freedom413/miniroot/img/9.png

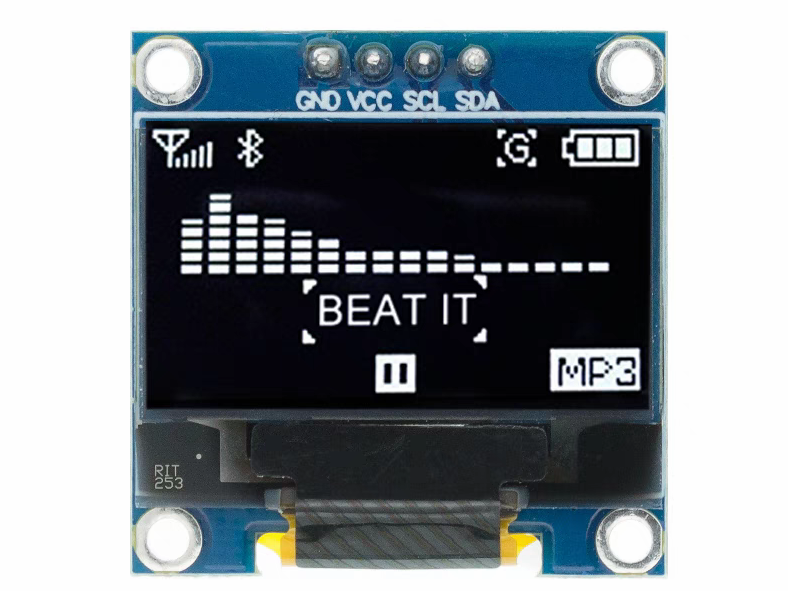
img/9.png
