freedom413/miniroot/img/正面.jpg

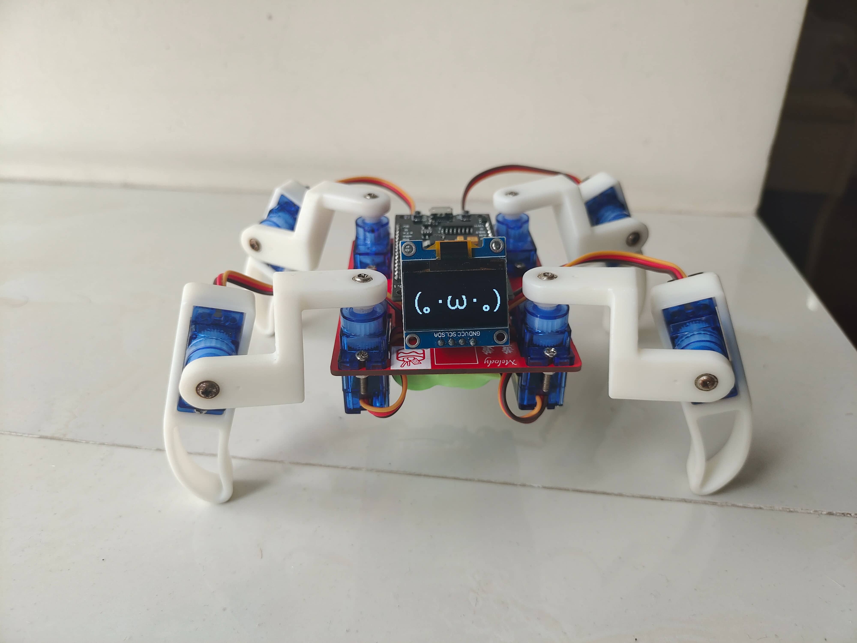
img/正面.jpg
