freedom413/miniroot/img/1.png

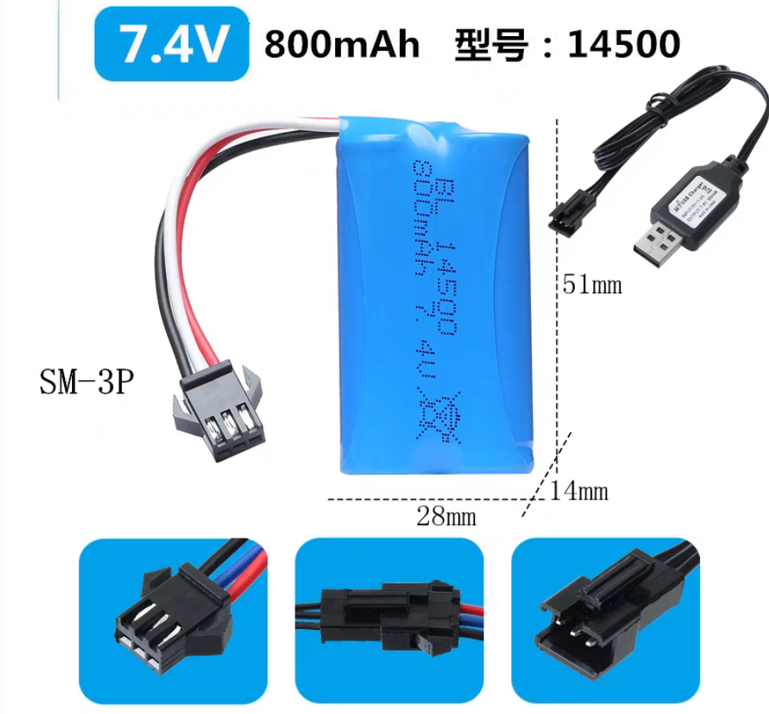
img/1.png
