freedom413/miniroot/img/2.png

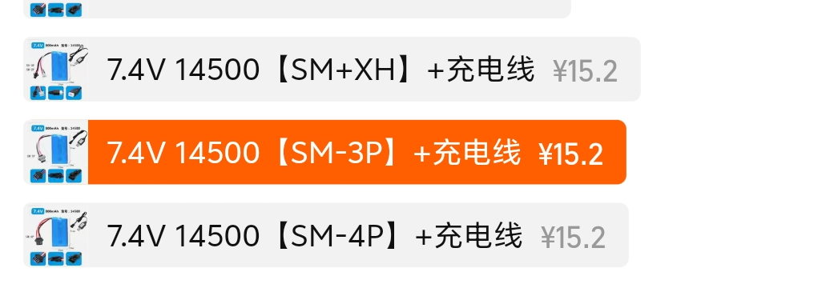
img/2.png
