freedom413/miniroot/img/3.png

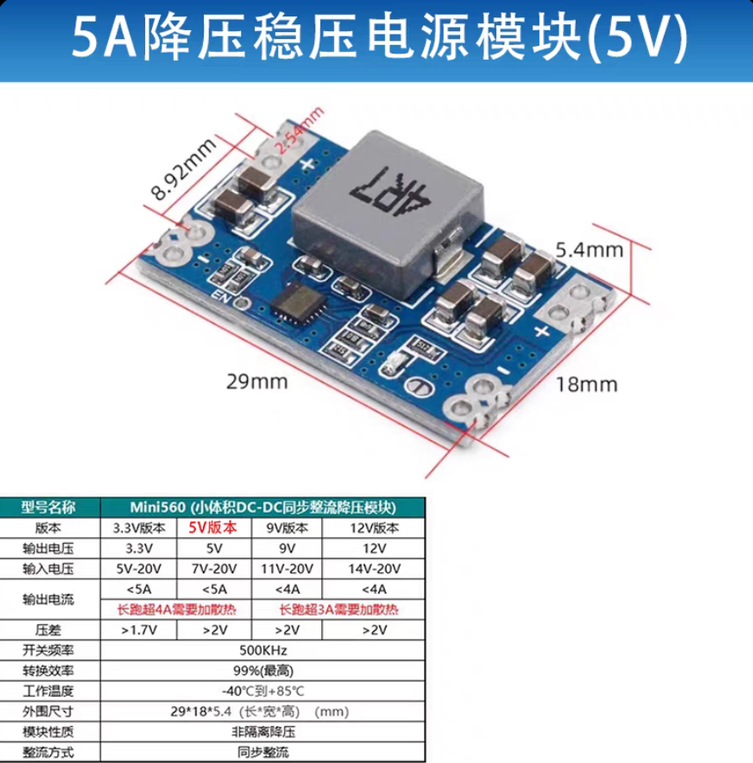
img/3.png
