freedom413/miniroot/img/4.png

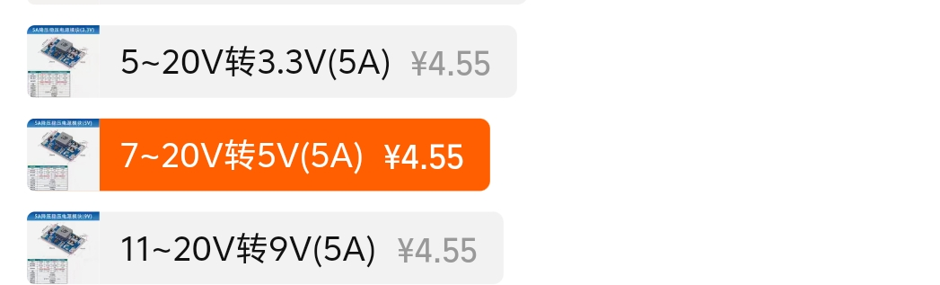
img/4.png
