freedom413/miniroot/img/5.png

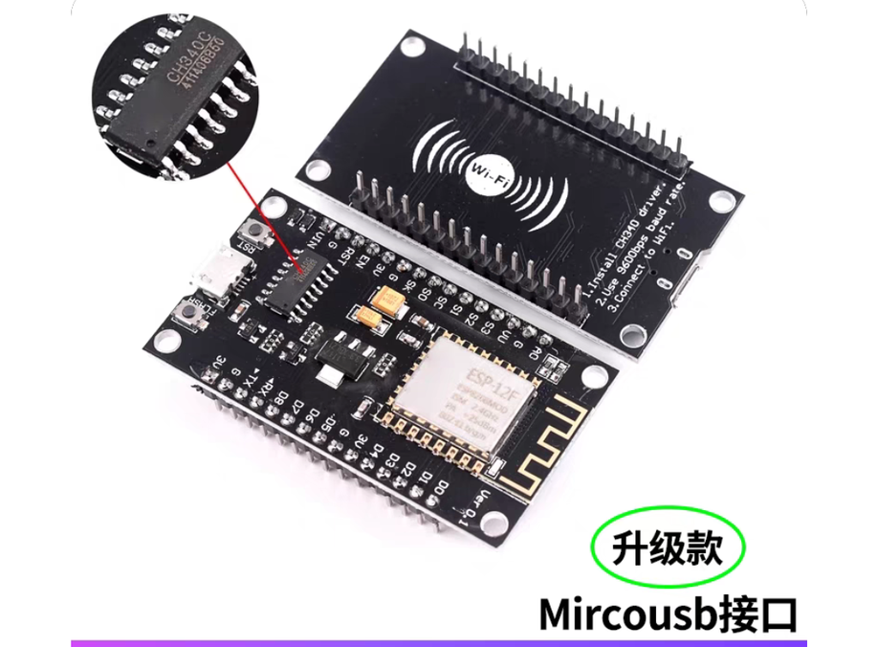
img/5.png
