freedom413/miniroot/img/6.png

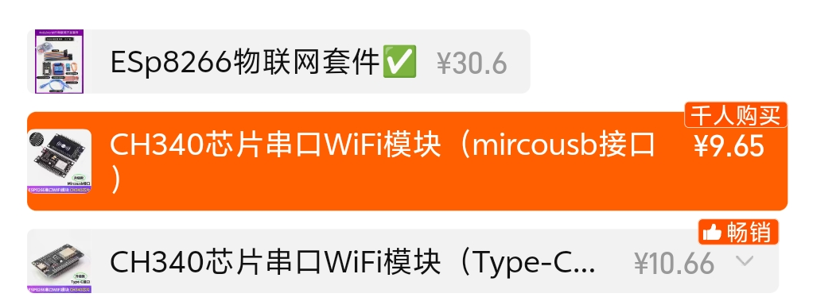
img/6.png
