freedom413/miniroot/img/7.png

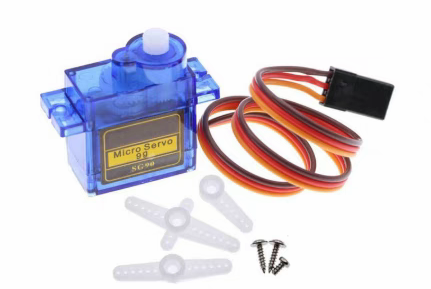
img/7.png
