freedom413/miniroot/img/8.png

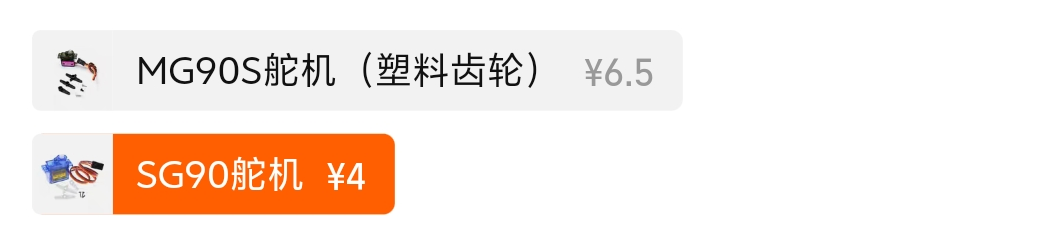
img/8.png
