freedom413/miniroot/img/10.png

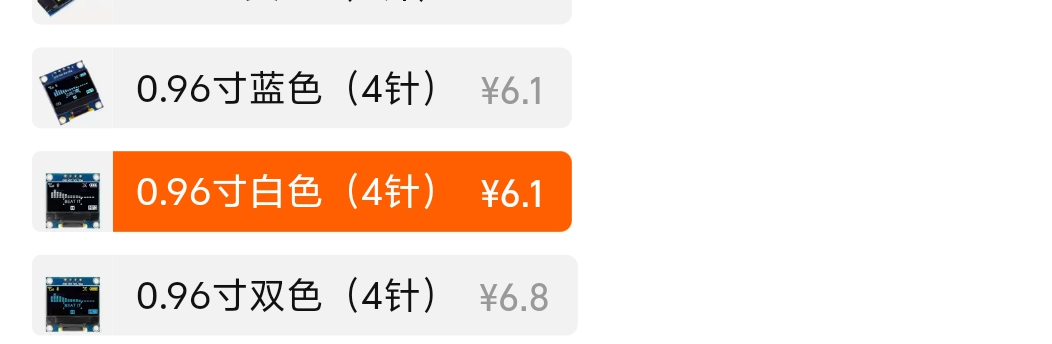
img/10.png
