freedom413/miniroot/img/11.png

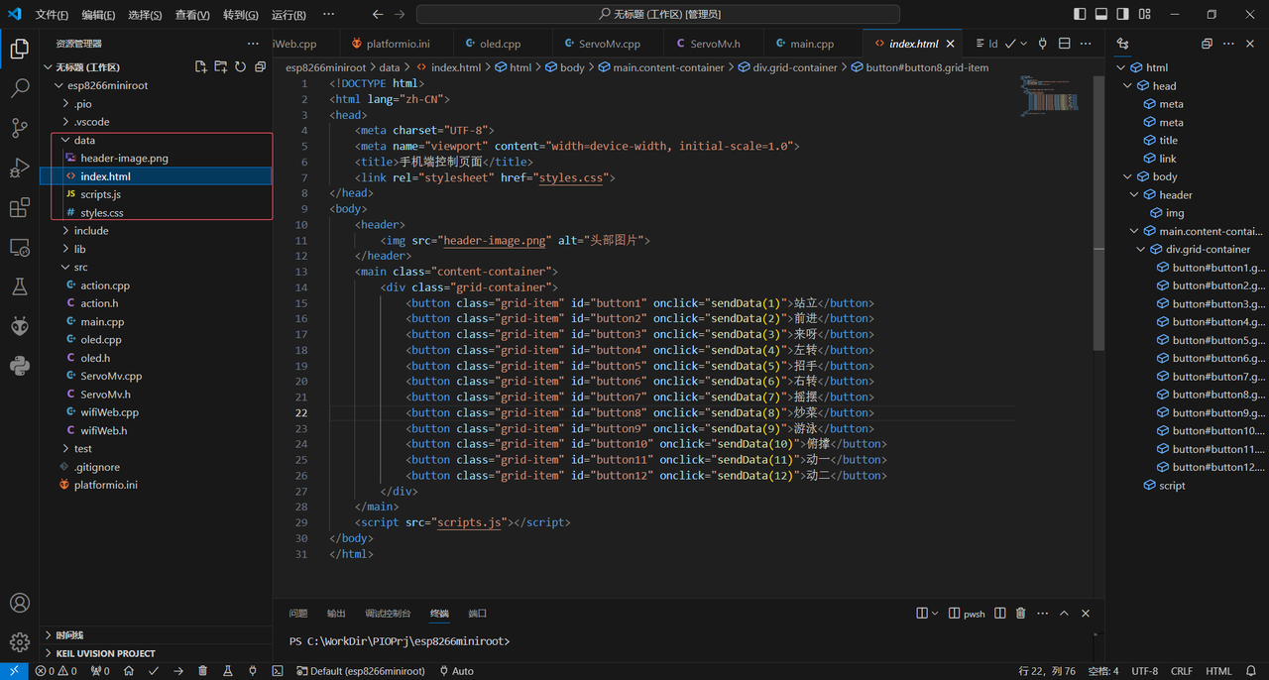
img/11.png
