freedom413/miniroot/img/12.png

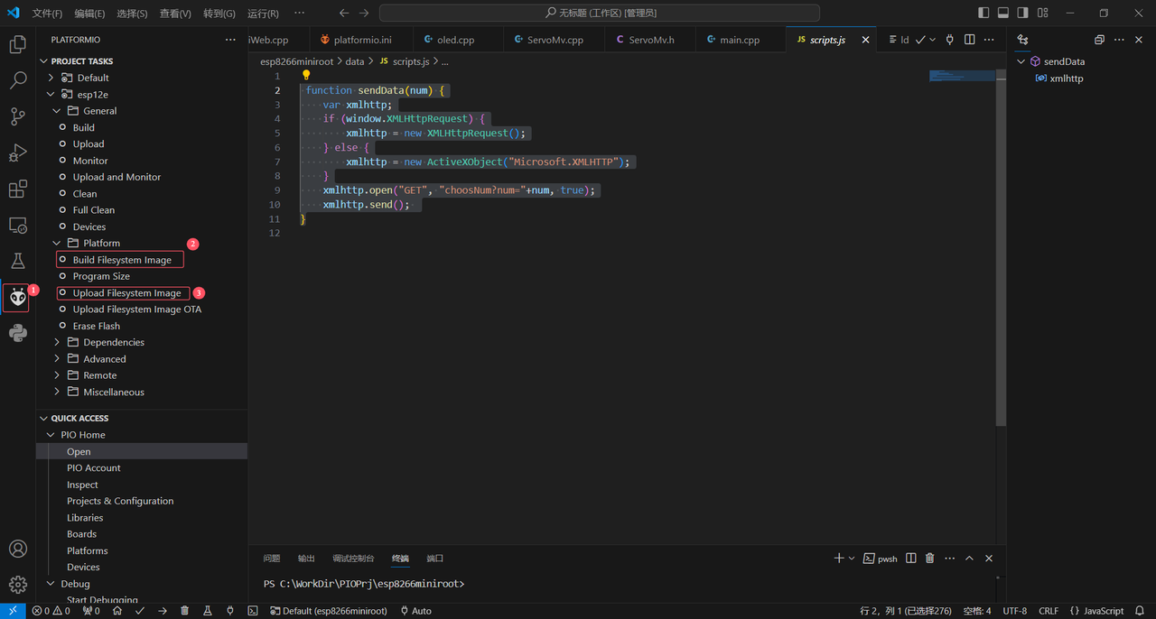
img/12.png
