freedom413/miniroot/img/model.png

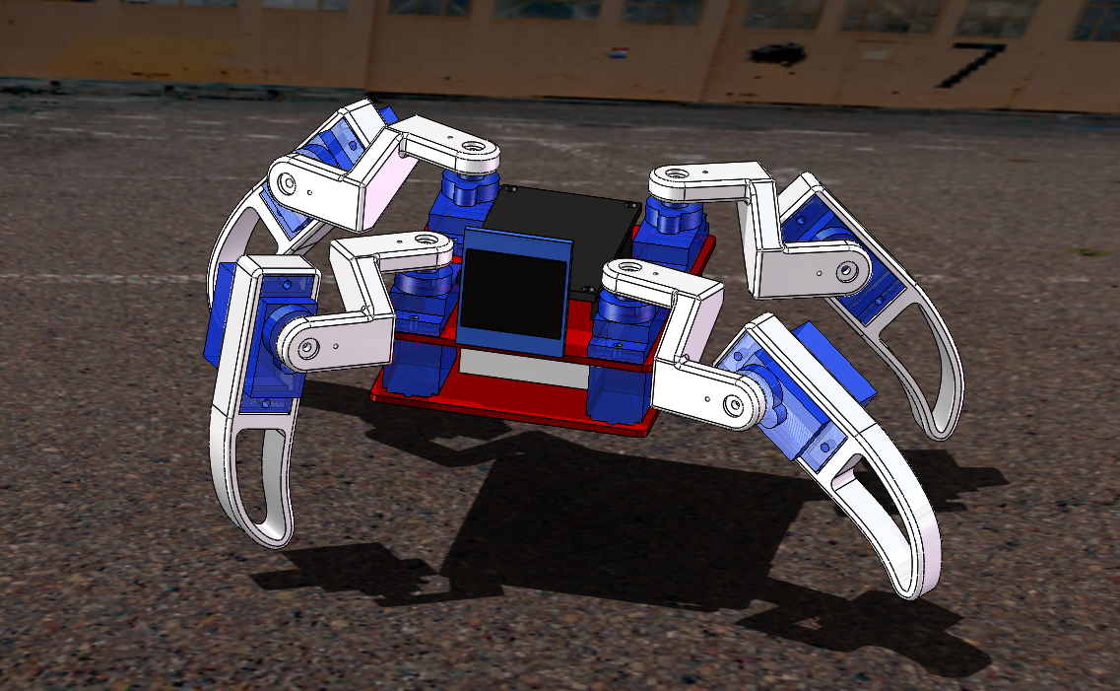
img/model.png
