freedom413/miniroot/img/p2.png

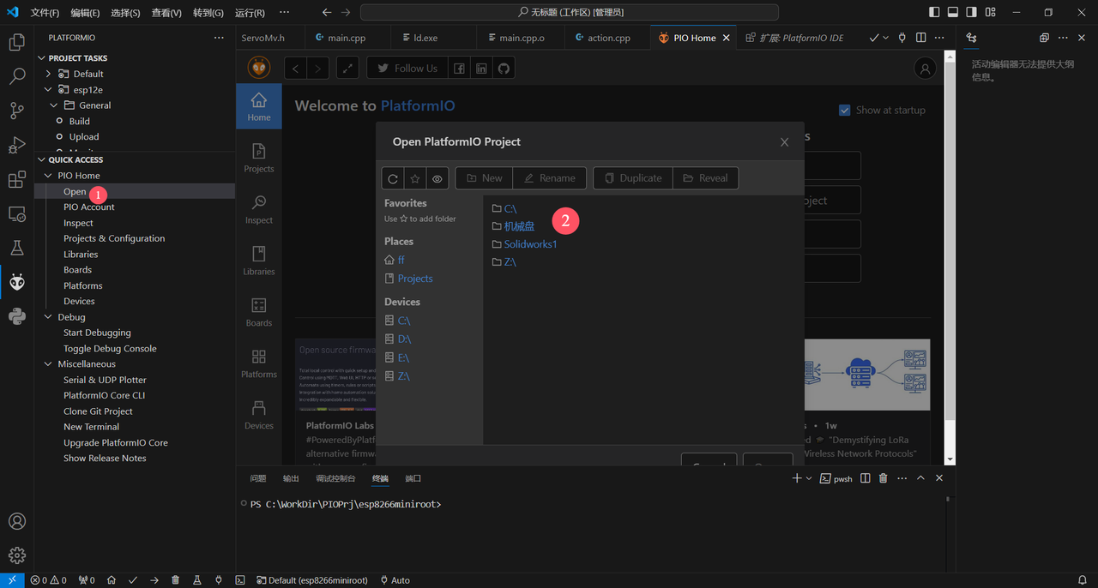
img/p2.png
