freedom413/miniroot/img/p3.png

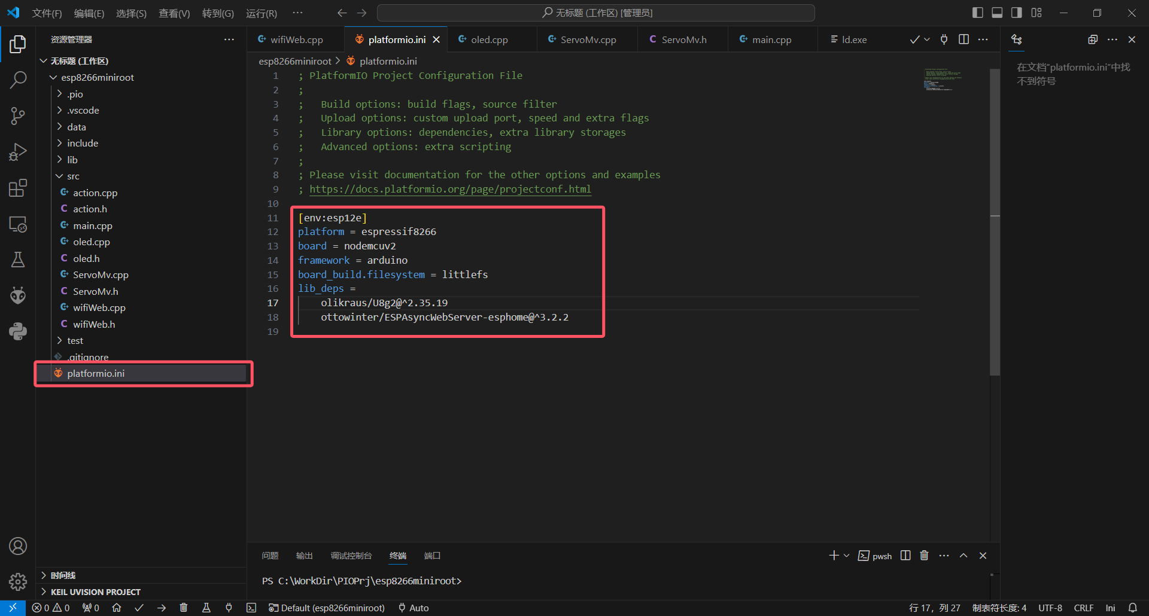
img/p3.png
