freedom413/miniroot/img/pcb.png

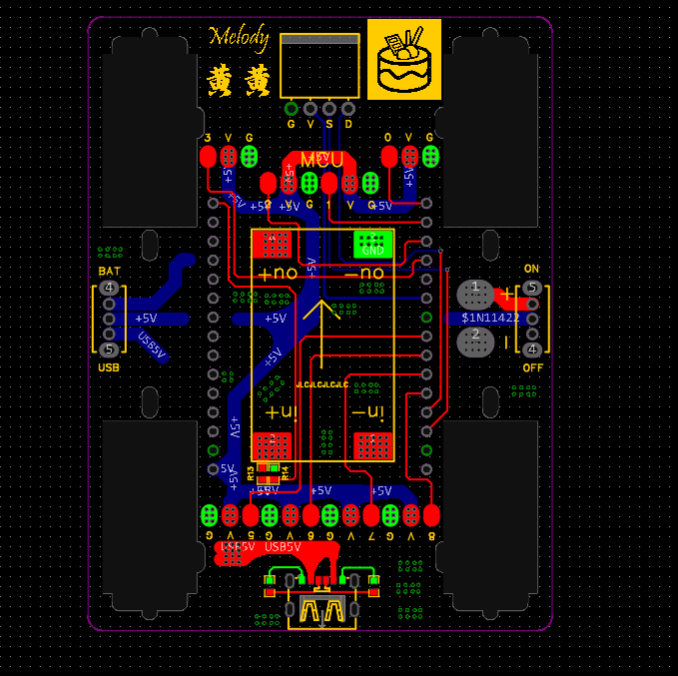
img/pcb.png
