freedom413/miniroot/img/ploat.png

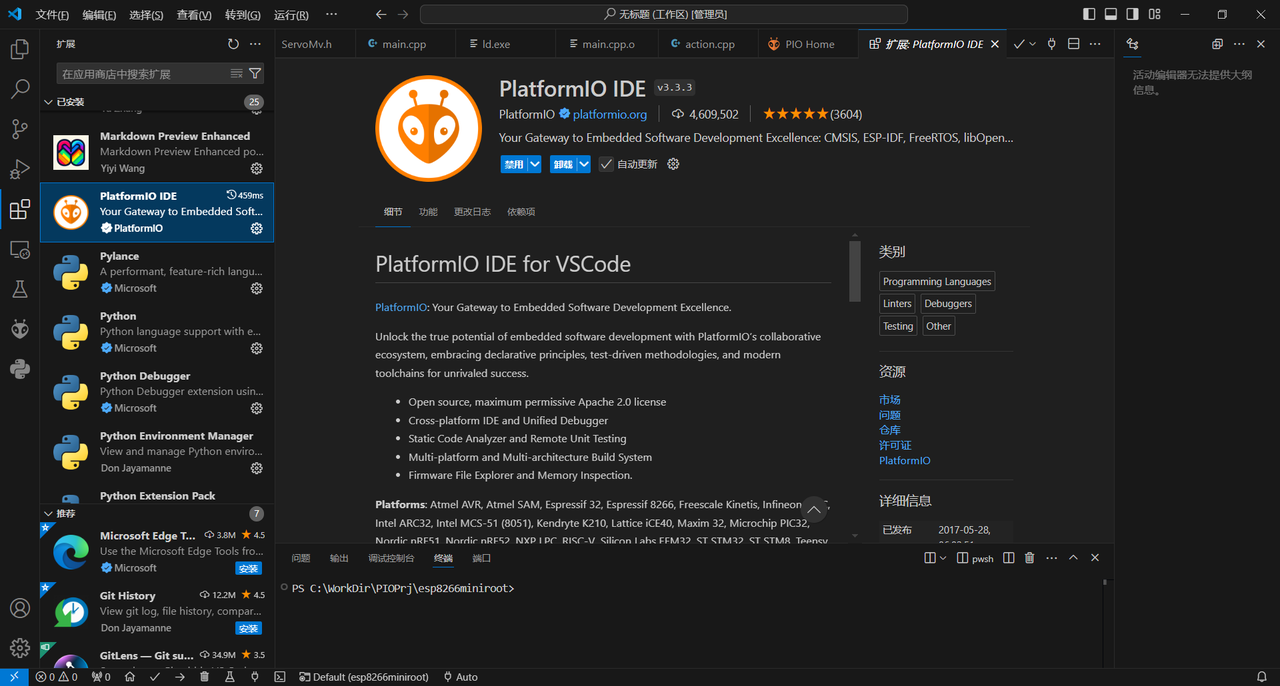
img/ploat.png
