freedom413/miniroot/img/root.png

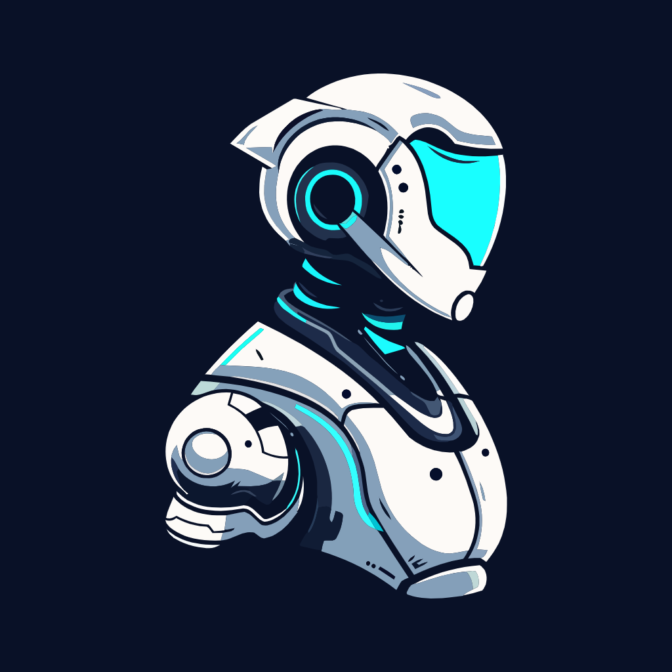
img/root.png
