freedom413/miniroot/img/sheet.png

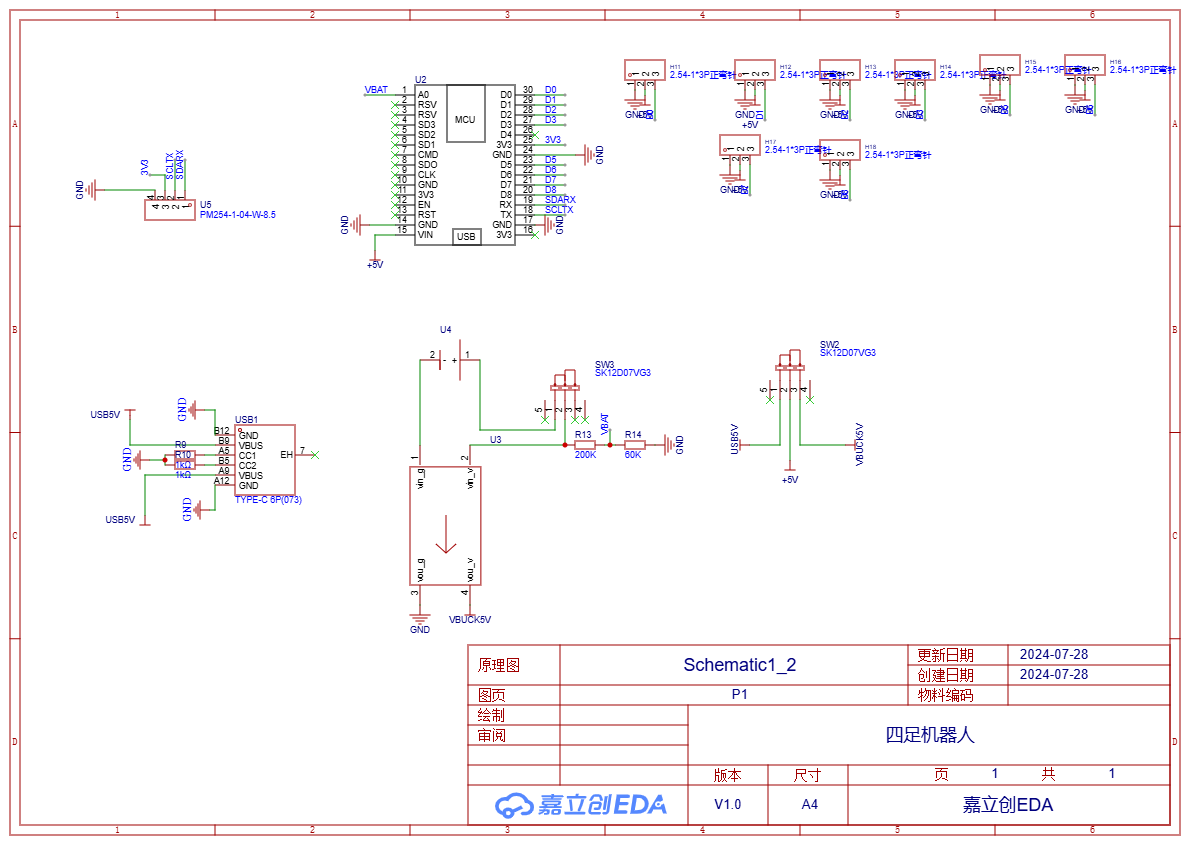
img/sheet.png
