freedom413/miniroot/img/web.png

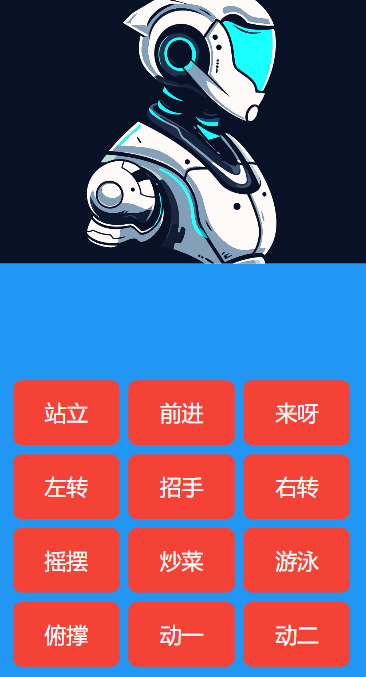
img/web.png
