freedom413/miniroot/img/侧面.jpg

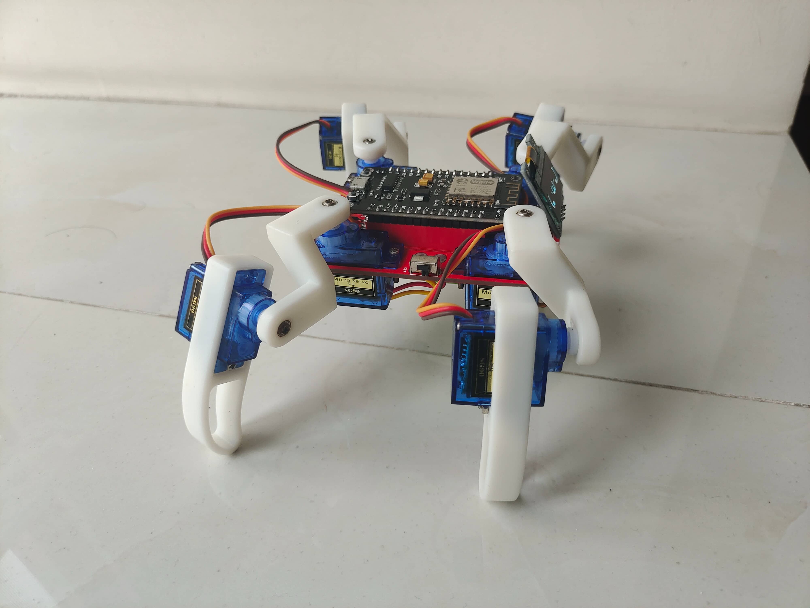
img/侧面.jpg
