freedom413/miniroot/img/屁股.jpg

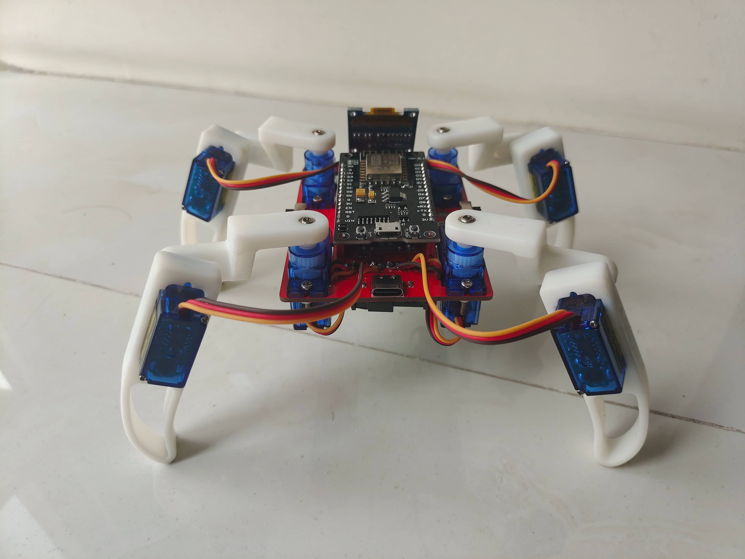
img/屁股.jpg
