freedom413/miniroot/img/架构图.png

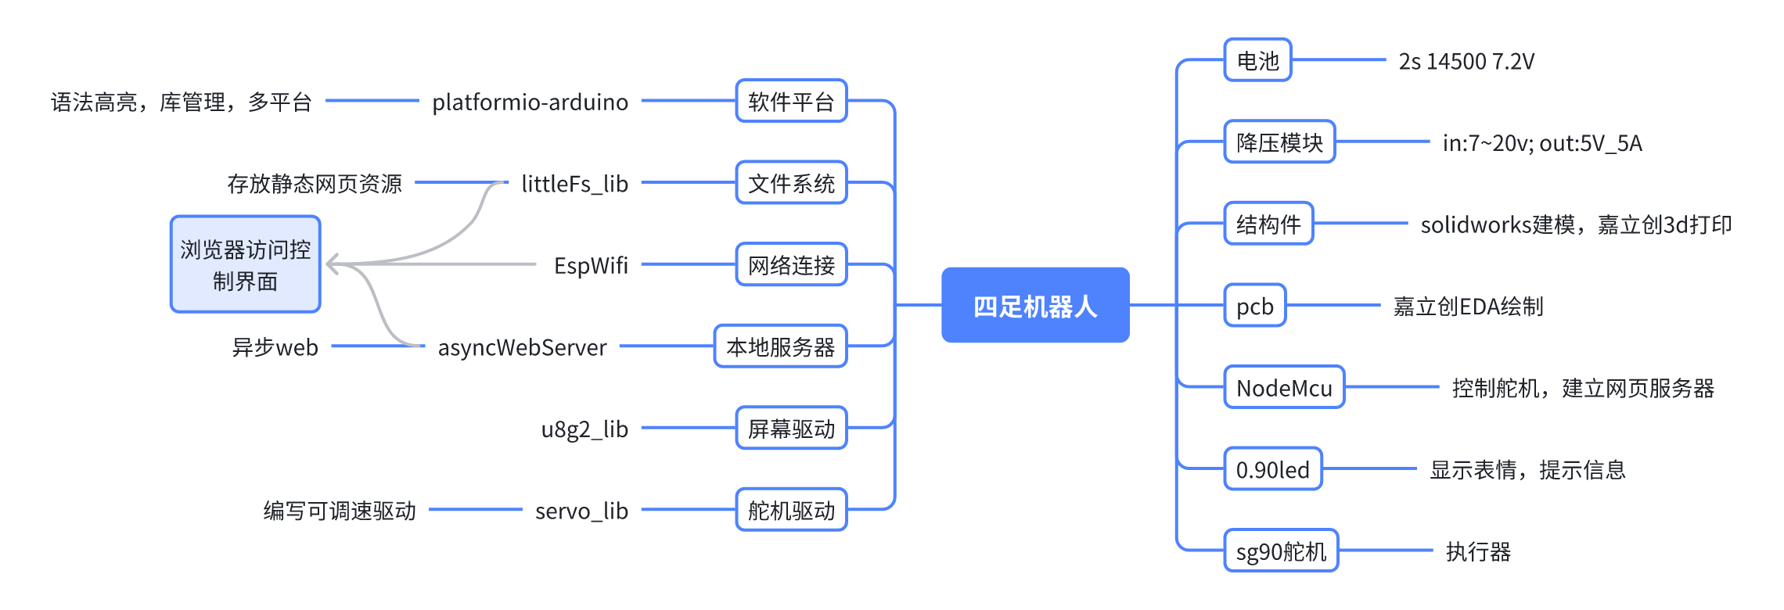
img/架构图.png
