freedom413/miniroot/img/肚皮.jpg

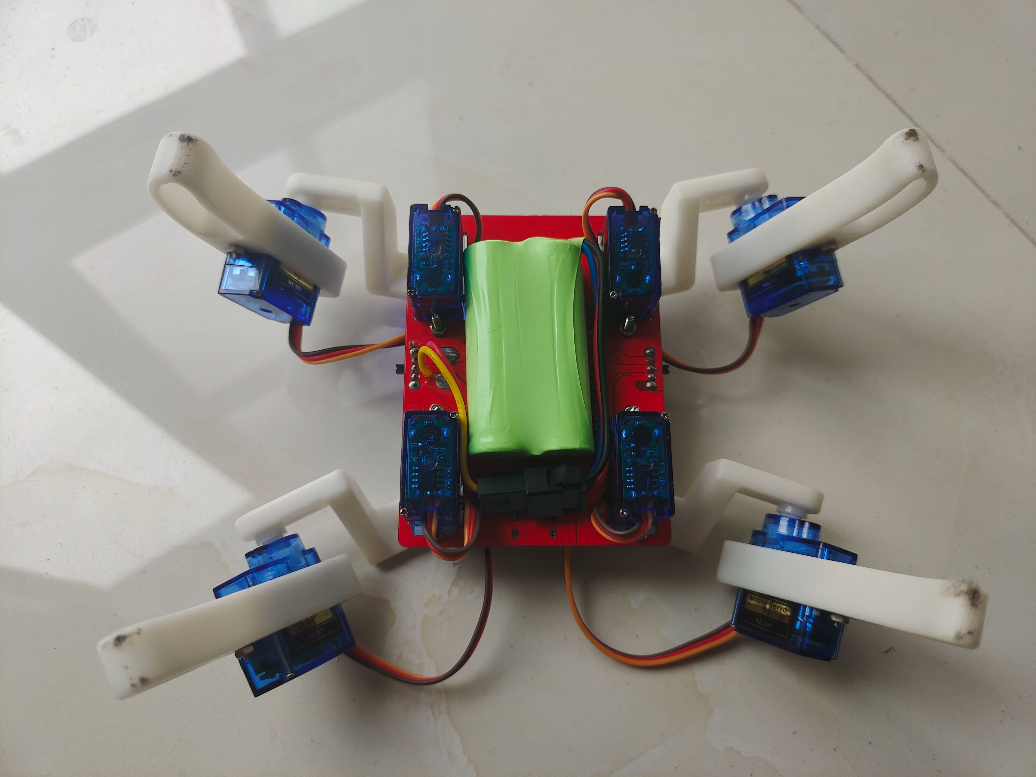
img/肚皮.jpg
