freedom413/miniroot/img/背面.jpg

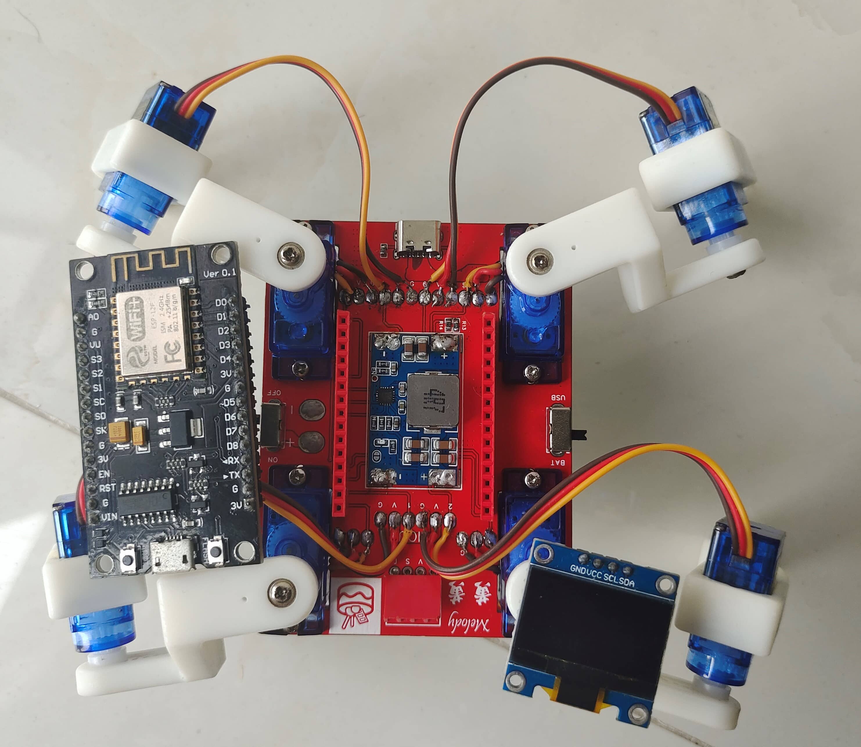
img/背面.jpg
