freedom413/miniroot/关节对照图_LI.jpg

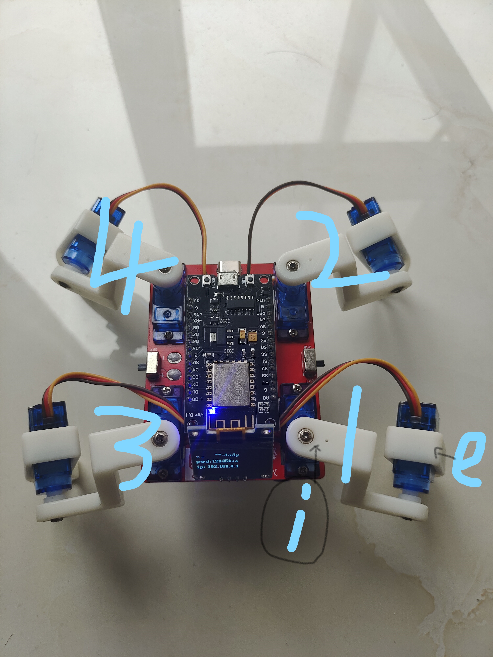
关节对照图_LI.jpg
