freedom413/miniroot/hardwear/SCH_Schematic1_2_2024-09-12 (1).pdf

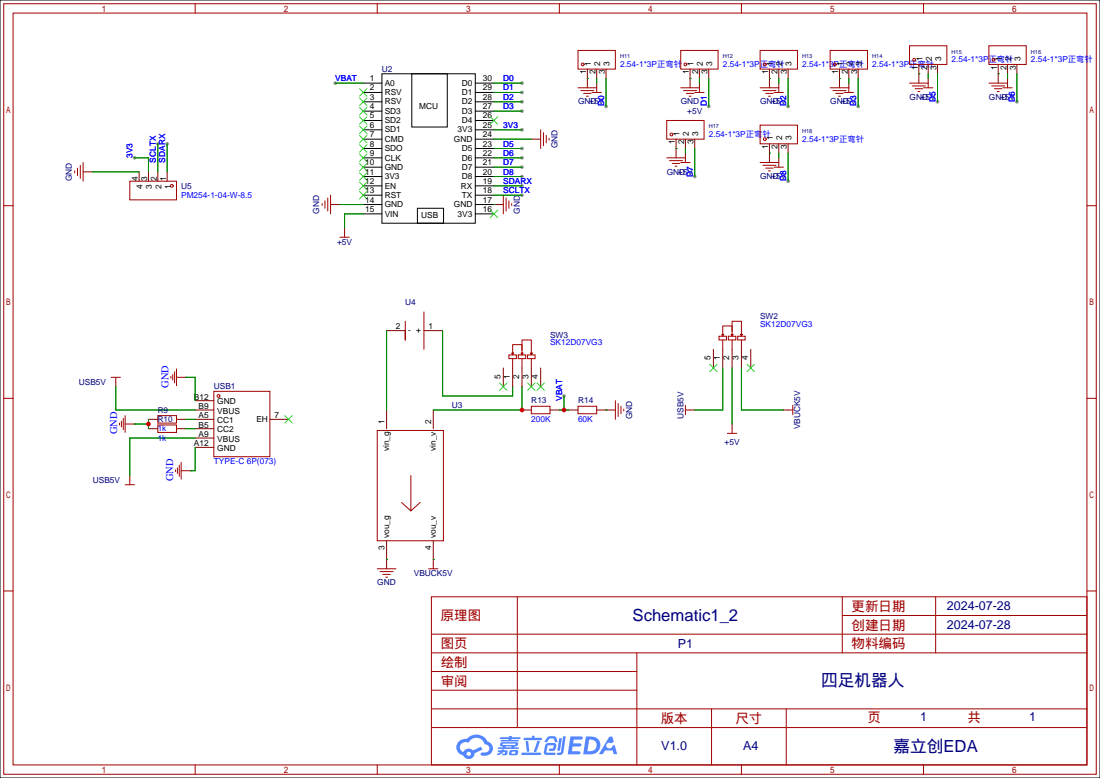
[picture p28: page 1]
