freedom413/miniroot/(list of files, drawings)

Other design files:
hardwear/ProDoc_Board1_2_2024-09-12 (1).epro
