freedom413/miniroot/softowear/esp8266miniroot/src/oled.cpp

#include <Arduino.h>
#include <U8g2lib.h>
// #include "data.h"
#include "wifiWeb.h"


//-----------------------------------------------oled表情开始--------------------------------------------------

/*----------颜文字定义----------*/

const  uint8_t  EmjZhuTou[] = 
{
0X00,0X01,0X80,0X00,0X37,0X00,
0XFC,0X00,0X07,0XFF,0XFF,0XFF,0XFF,0XFF,0X00,0X00,0X00,0X00,0X0C,0X03,0X80,0X0F,
0XF8,0X00,0X07,0XFF,0XFF,0XFF,0XFF,0XFF,0X80,0X00,0X00,0X00,0X06,0X01,0XE0,0X0F,
0XF8,0X00,0X0F,0XFF,0XFF,0XFF,0XFF,0XFF,0X80,0X00,0X00,0X00,0X07,0X81,0XE0,0X0F,
0XF0,0X00,0X1F,0XFF,0XFF,0XFF,0XFF,0XFF,0X80,0X00,0X00,0X00,0X07,0XE0,0XE0,0X07,
0XF0,0X00,0X3F,0XFF,0XFF,0XFF,0XFF,0XFF,0XC0,0X00,0X00,0X00,0X03,0XE0,0X70,0X03,
0XF0,0X00,0X7F,0XFF,0XFF,0XFE,0XFF,0XFF,0XC0,0X00,0X07,0XC0,0X03,0XE0,0X70,0X03,
0XF0,0X00,0X7F,0XFF,0XFF,0X7E,0XFF,0XFF,0XC0,0X00,0X08,0X60,0X01,0XF0,0X78,0X03,
0XE0,0X00,0XFF,0XFF,0XFF,0XFE,0XFF,0XFF,0XC0,0X00,0X13,0X90,0X01,0XF0,0X3C,0X03,
0XE0,0X01,0XFF,0XFF,0XFE,0XFC,0XFF,0XFF,0XC0,0X00,0X21,0XD0,0X01,0XF8,0X3C,0X03,
0XE0,0X01,0XFF,0XFF,0XFC,0XF7,0XFE,0XFF,0XC0,0X00,0X07,0XC0,0X00,0XF8,0X1E,0X03,
0XC0,0X03,0XFF,0XFF,0XFC,0XE1,0XFE,0XFF,0XC1,0XE0,0X06,0X40,0X00,0XF8,0X1E,0X03,
0XC0,0X07,0XDF,0XFF,0XF8,0X69,0XFE,0XFF,0XC3,0X00,0X02,0X80,0X00,0XFC,0X1F,0X01,
0XC0,0X07,0XBF,0XFF,0XF7,0XD2,0XFE,0XFF,0XC6,0X70,0X01,0X00,0X00,0X78,0X1F,0X01,
0XC0,0X0F,0XFF,0XFF,0XFF,0XF2,0XF4,0XFF,0XC4,0X70,0X00,0X00,0X00,0X70,0X0F,0X81,
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
0x00,0x07,0x00,0x30,0x00,0xC0,0x00,0x07,0x30,0x00,0x30,0x00,0xC0,0x00,0x70,0x00,
0x00,0x07,0x00,0x38,0x00,0xE0,0x00,0x0E,0x38,0x00,0x38,0x00,0xE0,0x00,0x70,0x00,
0x00,0x07,0x00,0x18,0x00,0x60,0x00,0x0E,0x18,0x00,0x18,0x00,0x60,0x00,0x70,0x00,
0x00,0x07,0x00,0x1C,0x00,0x70,0x00,0x1E,0x1C,0x00,0x1C,0x00,0x70,0x00,0x70,0x00,
0x00,0x07,0x00,0x1C,0x00,0x70,0x00,0x1C,0x0C,0x00,0x1C,0x00,0x70,0x00,0x70,0x00,
0x00,0x07,0x00,0x0C,0x00,0x30,0x00,0x1C,0x0C,0x00,0x0C,0x00,0x30,0x00,0x70,0x00,
0x00,0x07,0x00,0x0E,0x00,0x38,0x00,0x3C,0x06,0x00,0x0E,0x00,0x38,0x00,0x70,0x00,
0x00,0x07,0x00,0x06,0x00,0x18,0x00,0x38,0x06,0x00,0x06,0x00,0x18,0x00,0x70,0x00,
0x00,0x07,0x00,0x07,0x00,0x1C,0x00,0x78,0x03,0x00,0x07,0x00,0x1C,0x00,0x70,0x00,
0x00,0x07,0x00,0x03,0x00,0x0C,0x00,0x78,0x03,0x00,0x03,0x00,0x0C,0x00,0x70,0x00,
0x00,0x07,0x80,0x03,0x00,0x0E,0x00,0xF0,0x03,0x80,0x03,0x00,0x0E,0x00,0x70,0x00,
0x00,0x07,0x80,0x03,0x00,0x0E,0x00,0xF0,0x01,0x80,0x03,0x00,0x0E,0x00,0x70,0x00,
0x00,0x07,0x80,0x01,0x00,0x06,0x00,0xF0,0x01,0x80,0x01,0x00,0x06,0x00,0x70,0x00,
0x00,0x07,0xC0,0x01,0x00,0x07,0x00,0xE0,0x00,0xC0,0x01,0x00,0x07,0x00,0x70,0x00,
0x00,0x0E,0xC0,0x00,0x00,0x03,0x00,0x00,0x00,0xC0,0x00,0x00,0x03,0x00,0x30,0x00,
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
};

#define sclpin 1
#define sdapin 3

U8G2_SSD1306_128X64_NONAME_F_SW_I2C u8g2(U8G2_R2, /* clock=*/sclpin, /* data=*/sdapin, /* reset=*/U8X8_PIN_NONE);

U8G2_SSD1306_128X64_NONAME_F_SW_I2C& getoledhand(void)
{
  return u8g2;
}


void OledInit(void)
{

  // OLED初始化
  u8g2.begin();                       // 初始化
  u8g2.clearBuffer();                 // clear the internal memory
  u8g2.setFont(u8g2_font_ncenB08_tr); // choose a suitable font
  delay(1000);
}

// 表情----------------------------
void BQ_TT(void)
{
  u8g2.clearBuffer();
  u8g2.drawXBMP(2, 2, 128, 64, EmjZhuTou);
  u8g2.sendBuffer();
  delay(20);
}
// 友好
void BQ_yh(void)
{

  u8g2.clearBuffer();
  u8g2.drawXBMP(2, 2, 128, 64, EmjYouHao);
  u8g2.sendBuffer();
  delay(20);
}
// 正常
void BQ_zc(void)
{

  u8g2.clearBuffer();
  u8g2.drawXBMP(2, 2, 128, 64, EmjZhengChang);
  u8g2.sendBuffer();
  delay(20);
}
// 猪
void BQ_sj(void)
{

  u8g2.clearBuffer();
  u8g2.drawXBMP(2, 2, 128, 64, EmjShuiJiao);
  u8g2.sendBuffer();
  delay(20);
}
// 你好
void BQ_nh(void)
{

  u8g2.clearBuffer();
  u8g2.drawXBMP(2, 2, 128, 64, EmjNiHao);
  u8g2.sendBuffer();
  delay(20);
}
//
void BQ_la(void)
{

  u8g2.clearBuffer();
  u8g2.drawXBMP(2, 2, 128, 64, EmjLaia);
  u8g2.sendBuffer();
  delay(20);
}
// 狗刨
void BQ_gp(void)
{

  u8g2.clearBuffer();
  u8g2.drawXBMP(2, 2, 128, 64, EmjGouPao);
  u8g2.sendBuffer();
  delay(20);
}
// 投降
void BQ_tx(void)
{

  u8g2.clearBuffer();
  u8g2.drawXBMP(2, 2, 128, 64, EmjTouXiang);
  u8g2.sendBuffer();
  delay(20);
}
// 摇摆
void BQ_yb(void)
{

  u8g2.clearBuffer();
  u8g2.drawXBMP(2, 2, 128, 64, EmjYaoBai);
  u8g2.sendBuffer();
  delay(20);
}
// 表情----------------------------end

// wifi信息提示---------------
void INF_ipdis(void)
{
  u8g2.clearBuffer();    // 清除缓冲区
  u8g2.setCursor(0, 15); // 方式2，设置光标到达0 15位置
  u8g2.print("wifi:");
  u8g2.setCursor(34, 15);
  u8g2.print(GetWifiName());

  u8g2.setCursor(0, 31); // 方式2，设置光标到达0 15位置
  u8g2.print("pwd:");
  u8g2.setCursor(28, 31);
  u8g2.print(GetWifipwd());

  u8g2.setCursor(0, 47);
  u8g2.print("ip:");
  u8g2.setCursor(19, 47);
  u8g2.print(GetWifiIp().c_str()); // 在光标处打印字符串
  u8g2.sendBuffer();      // 显示缓冲区的内容
}

void INF_wifi_err(void)
{
  u8g2.clearBuffer();    // 清除缓冲区
  u8g2.setCursor(0, 12); // 方式2，设置光标到达0 12位置
  u8g2.print("wifi_err:seting wifi");
  u8g2.setCursor(0, 27);
  u8g2.print("name:gf_esp8266");
  u8g2.setCursor(0, 42);
  u8g2.print("passwd:12345678");
  u8g2.setCursor(0, 57);
  u8g2.print("ReStart Later");
  u8g2.sendBuffer(); // 显示缓冲区的内容
}
// wifi信息提示---------------end
void INF_wifi_wiat(void)
{

  u8g2.clearBuffer();    // 清除缓冲区
  u8g2.setCursor(0, 12); // 方式2，设置光标到达0 12位置
  u8g2.print("........");
  u8g2.display(); // 显示缓冲区的内容
  delay(300);
  u8g2.clearDisplay();   // 清除缓冲区
  u8g2.setCursor(0, 12); // 方式2，设置光标到达0 12位置
  u8g2.print("wiat...");
  u8g2.sendBuffer(); // 显示缓冲区的内容
}
