freedom413/miniroot/softowear/esp8266miniroot/src/action.h

#ifndef __ACTION_H__
#define __ACTION_H__


void MV_zcc(void);
void MV_dfpos(void);
void MV_haha(void);
void MV_go(void);

void MV_back(void);

void MV_yo(void);

void MV_yz(void);

void MV_yy(void);

void MV_zz(void);

void MV_ly(void);

void MV_zs(void);

void MV_yba(void);

void MV_fwc(void);

void MV_Jump(void);

void MV_D1(void);
void MV_D2(void);

#endif
