freedom413/miniroot/(commit log)

2024-09-15 第二次更改readme
2024-09-15 第三次更改readme
2024-09-15 第四次更改readme
2024-09-15 Update README.md
    加入博客
2024-09-16 修改RAEDME图片为图床
2024-09-16 去除img文件夹
